NeverNotJohn/CSUF-NASA-USLI-2026/README.md

# California State University, Fresno NASA USLI 
California State University, Fresno (CSUF) GitHub for the 2025-2026 NASA USLI Competition 

## File Structure
### Hardware
Schematics, PCB, KiCad project, etc.
### Software
Code made in C/C++ using FreeRTOS and Arduino. Development using the PlatformIO IDE
