NeverNotJohn/CSUF-NASA-USLI-2026/payload/hardware/VDF/High_Voltage_Sled/CSUF-USLI-payload-2026.png

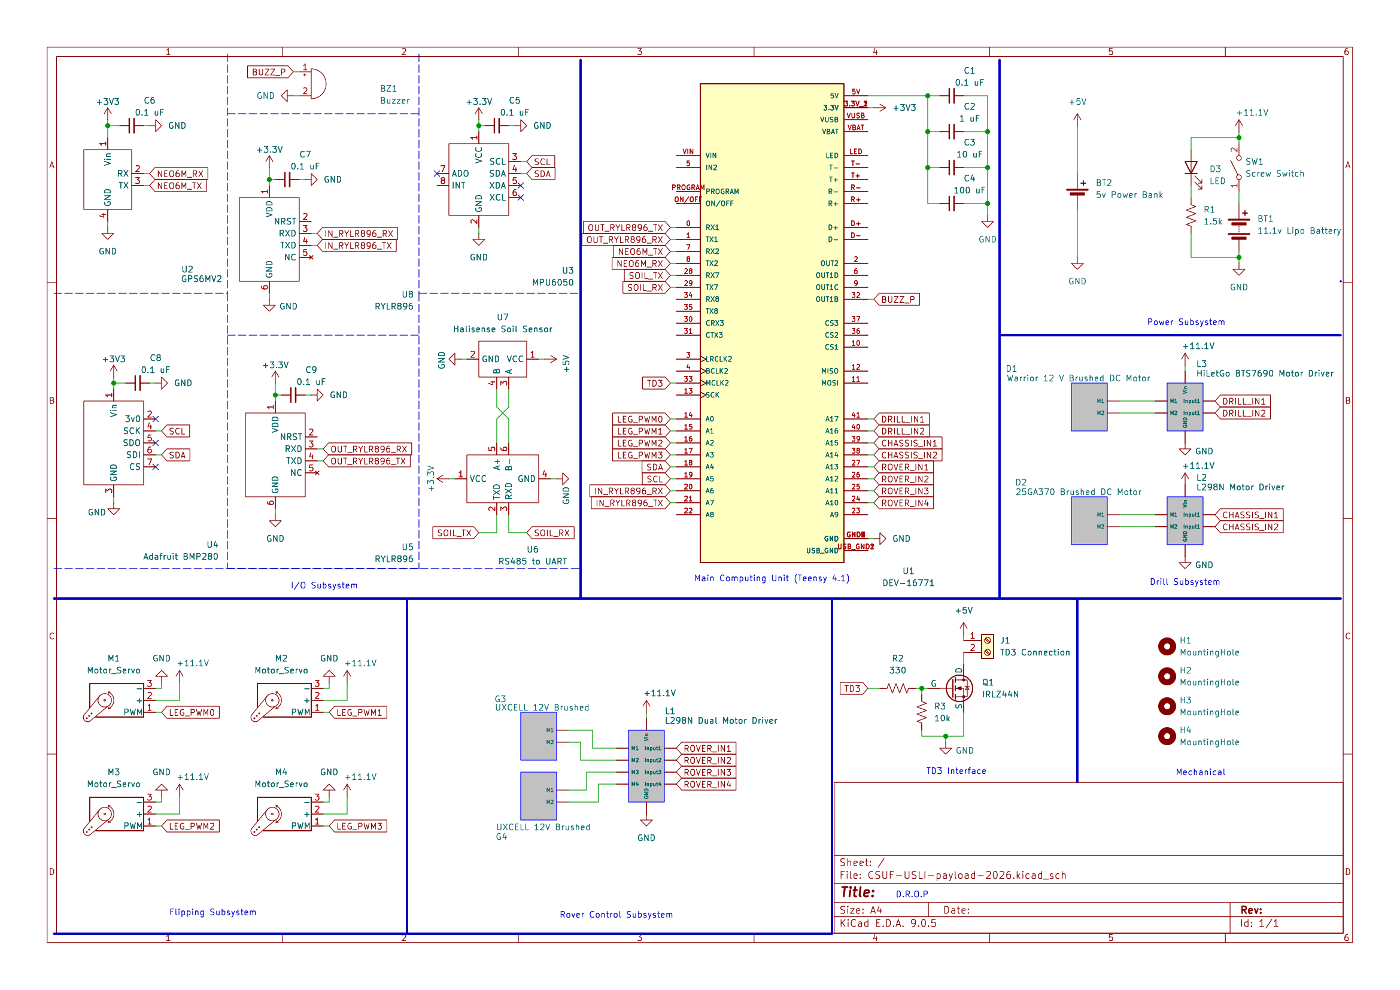
payload/hardware/VDF/High_Voltage_Sled/CSUF-USLI-payload-2026.png
