NeverNotJohn/CSUF-NASA-USLI-2026/payload/hardware/CSUF-USLI-payload-V2-2026/models/IRLZ44N.step

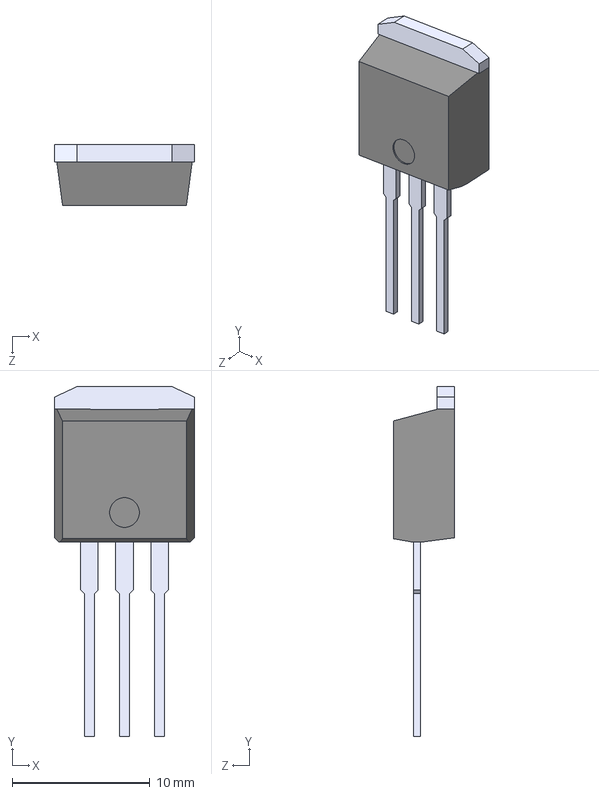
[picture p2: CAD file, 2026-03-28]
payload/hardware/CSUF-USLI-payload-V2-2026/models/IRLZ44N.step
10.2 x 25.4 x 4.44 mm
