NeverNotJohn/CSUF-NASA-USLI-2026/payload/hardware/CSUF-USLI-payload-V2-2026/models/DEV-16771.step

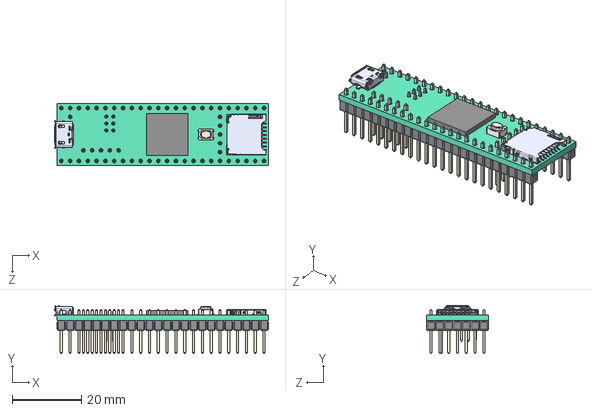
[picture p3: CAD file, 2025-10-14]
payload/hardware/CSUF-USLI-payload-V2-2026/models/DEV-16771.step
61.7 x 13.8 x 17.8 mm
