NeverNotJohn/CSUF-NASA-USLI-2026/payload/hardware/VDF/High_Voltage_Sled/CSUF-USLI-payload-2026.pdf

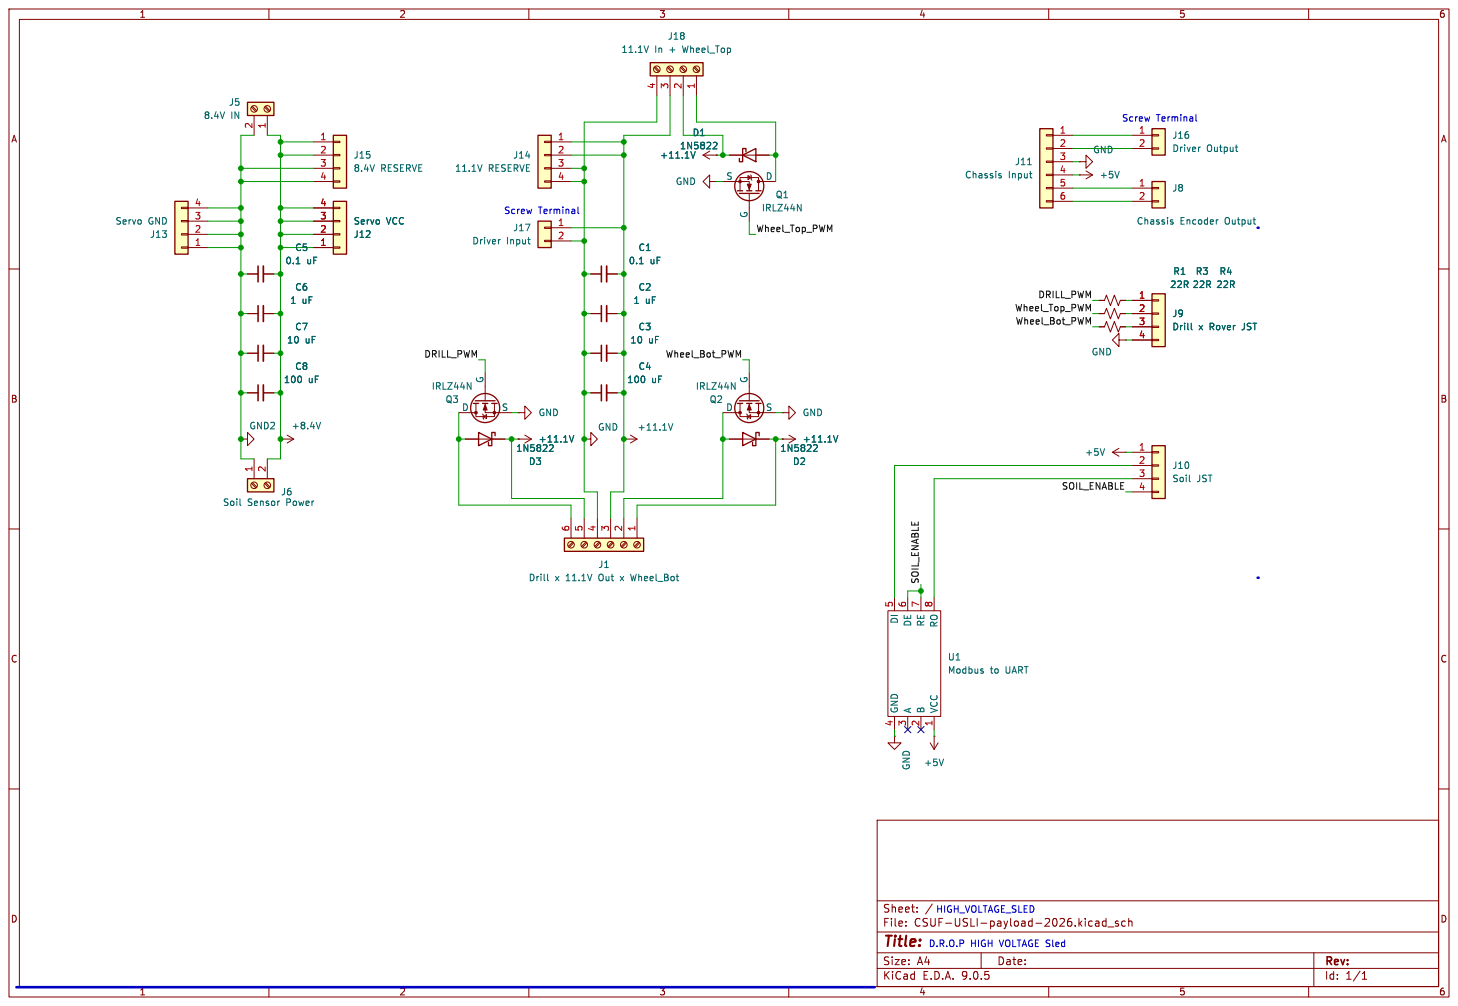
[picture p4: page 1]

J8 Chassis Encoder Output GND

Id: 1/1 Title: File: CSUF-USLI-payload-2026.kicad_sch Sheet: /
