NeverNotJohn/CSUF-NASA-USLI-2026/payload/hardware/VDF/Sensor_Sled/CSUF-USLI-payload-2026.pdf

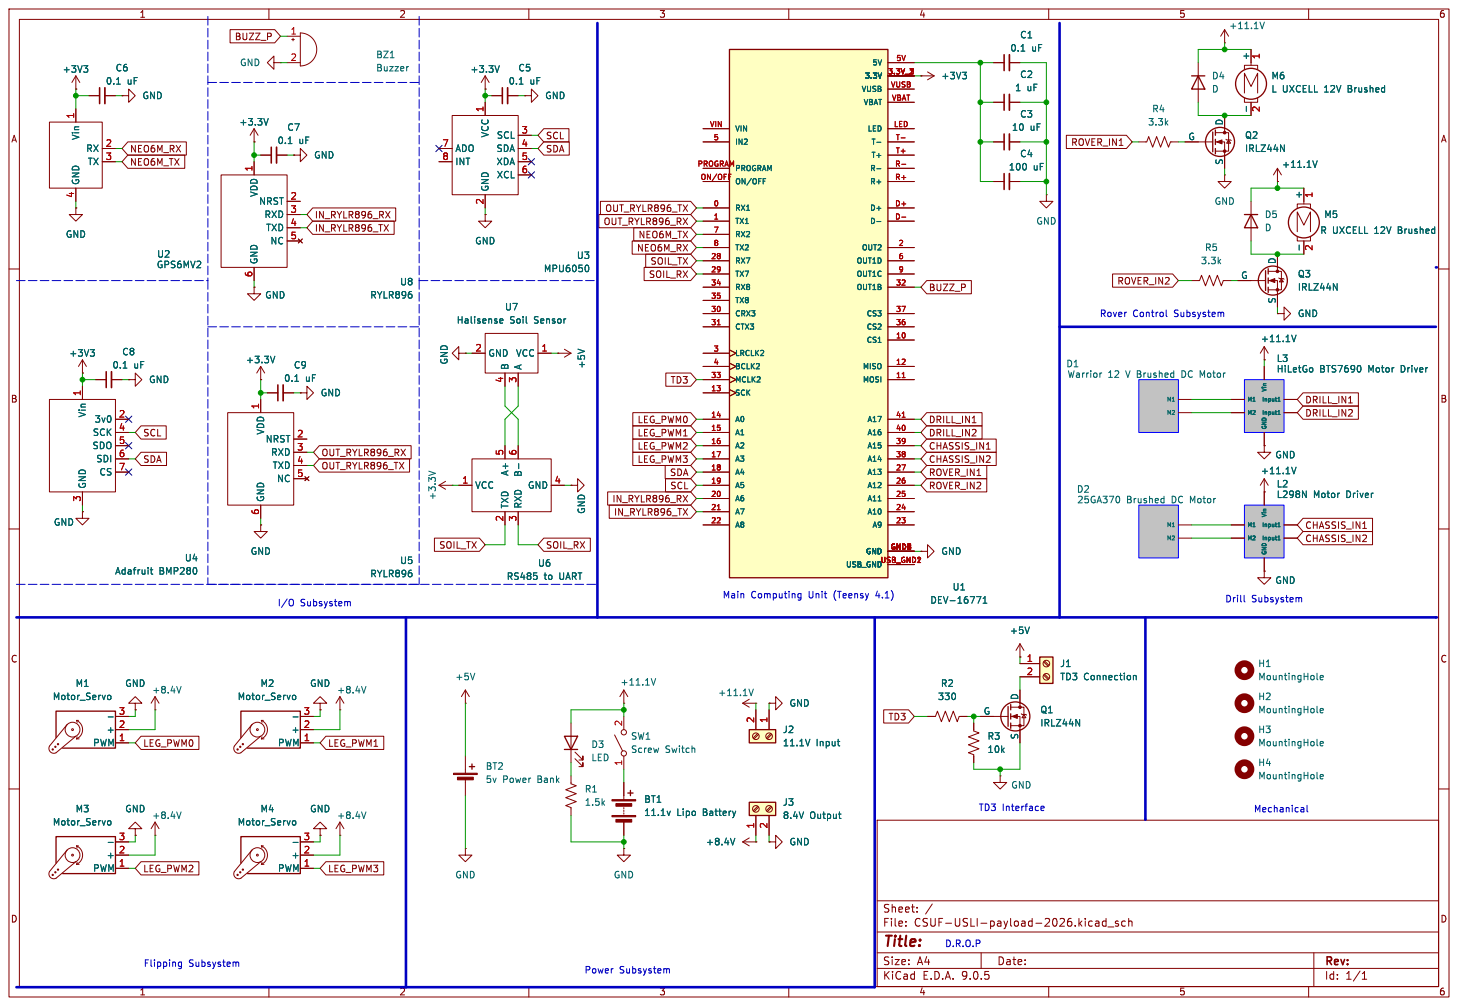
[picture p5: page 1]

2 SCL 3 SDA 4 XDA 5 XCL 6 +3.3V GND +5V U6 RS485 to UART TXD

6 NRST 2 RXD 3 TXD 4 NC 5 GND GND

2 SCL 3 SDA 4 XDA 5 XCL 6 U3 MPU6050 PWM 1 +

4 RX 2 TX 3 U2 GPS6MV2 GND GND

6 NRST 2 RXD 3 TXD 4 NC 5 U5 RYLR896 GNDVDD

6 NRST 2 RXD 3 TXD 4 NC 5 U8 RYLR896 +8.4V C9

4 U7 Halisense Soil Sensor GND

5 B- 6 U7 Halisense Soil Sensor VCC 1 GND 2 A

L3HiLetGo BTS7690 Motor Driver M1 M2 Vin GND

6 NRST 2 RXD 3 TXD 4 NC 5 GND

Input1L2
L298N Motor Driver M1 M2 Vin GND
M1 M2 Vin GND

H1 MountingHole H4 MountingHole H2 MountingHole H3 MountingHole G

Id: 1/1 Title: File: CSUF-USLI-payload-2026.kicad_sch Sheet: /
