NeverNotJohn/CSUF-NASA-USLI-2026/payload/hardware/CSUF-USLI-payload-V2-2026/main-board-v2.kicad_pcb

## KiCad design payload/hardware/CSUF-USLI-payload-V2-2026/main-board-v2.kicad_pcb (2026-04-13)

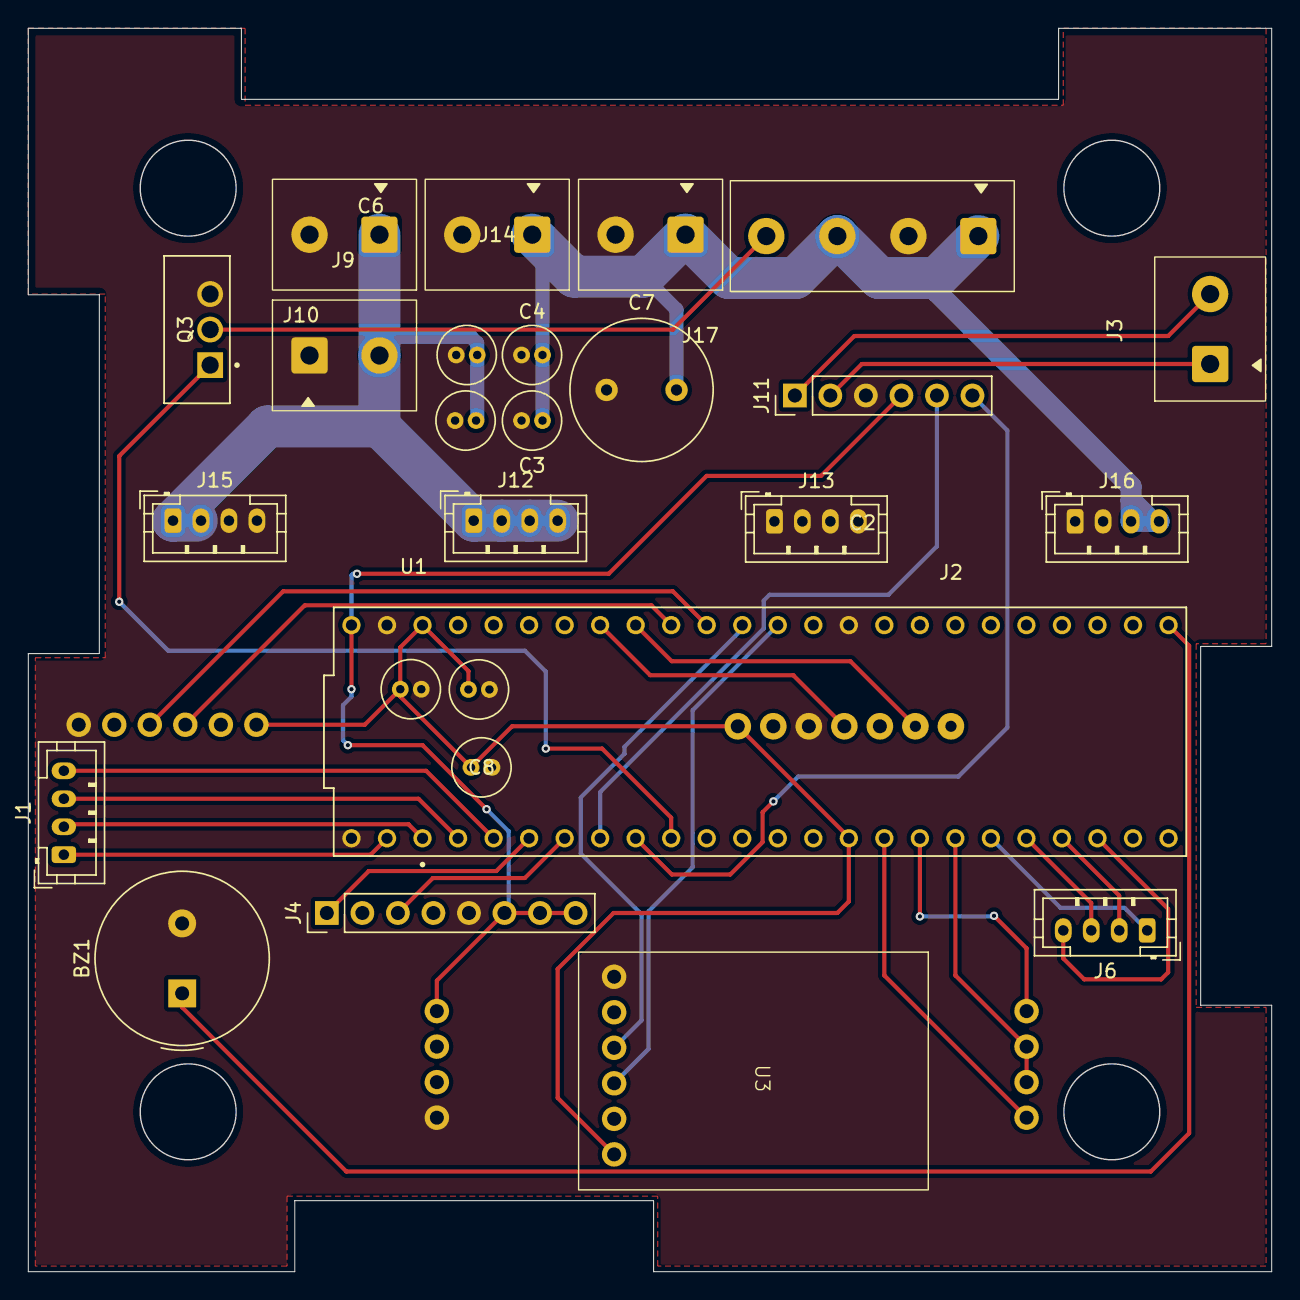
[picture p6: board main-board-v2.kicad_pcb from above]

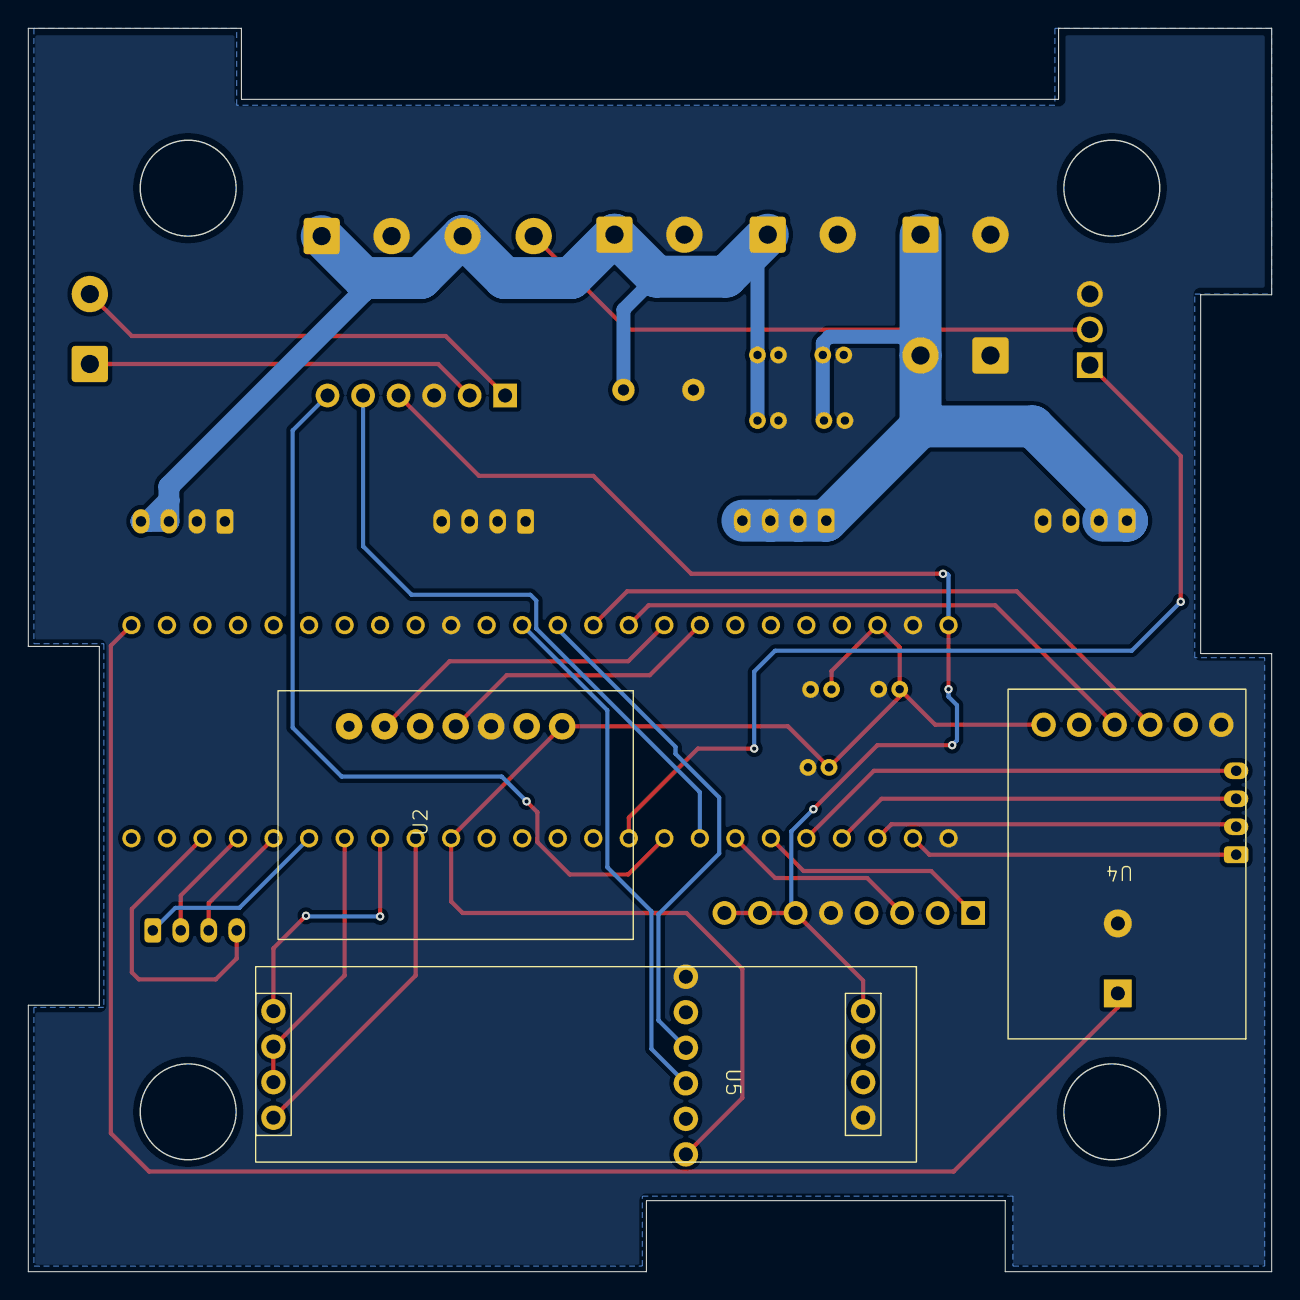
[picture p7: board main-board-v2.kicad_pcb from below]

Board: 2 copper layers, 88.9 x 88.9 mm, 29 parts (3 on the bottom side), 31 nets.

Parts:
BZ1: Buzzer; Buzzer_TDK_PS1240P02BT_D12.2mm_H6.5mm
C1, C2, C3, C5, C8: 0.1 uF; C_Radial_D4.0mm_H7.0mm_P1.50mm
C4, C6: 1 uF; C_Radial_D4.0mm_H7.0mm_P1.50mm
C7: 330 uF; C_Radial_D10.0mm_H12.5mm_P5.00mm
J1: Servo JST; JST_PH_B4B-PH-K_1x04_P2.00mm_Vertical
J2: Drill x 11.1V OUT; Edit_TerminalBlock_Phoenix_MKDS-1,5-2_1x04_P5.00mm_Horizont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
J3: Motor Power; Edit_TerminalBlock_Phoenix_MKDS-1,5-2_1x02_P5.00mm_Horizont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
J4: BTS7960 Output; PinHeader_1x08_P2.54mm_Vertical
J6: Reserve JST; JST_PH_B4B-PH-K_1x04_P2.00mm_Vertical
J9: Soil Sensor Power; Edit_TerminalBlock_Phoenix_MKDS-1,5-2_1x02_P5.00mm_Horizont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
J10: 8.4V IN; Edit_TerminalBlock_Phoenix_MKDS-1,5-2_1x02_P5.00mm_Horizont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
J11: Chassis Input; PinHeader_1x06_P2.54mm_Vertical
J12: Servo VCC; JST_PH_B4B-PH-K_1x04_P2.00mm_Vertical
J13: Servo GND; JST_PH_B4B-PH-K_1x04_P2.00mm_Vertical
J14: 11.1V IN; Edit_TerminalBlock_Phoenix_MKDS-1,5-2_1x02_P5.00mm_Horizont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
J15: 8.4V RESERVE; JST_PH_B4B-PH-K_1x04_P2.00mm_Vertical
J16: 11.1V RESERVE; JST_PH_B4B-PH-K_1x04_P2.00mm_Vertical
J17: Driver Input; Edit_TerminalBlock_Phoenix_MKDS-1,5-2_1x02_P5.00mm_Horizont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
Q3: IRLZ44N
U1: DEV-16771; MODULE_DEV-16771
U2: Adafruit BMP280; BMP280
U3, U4: RYLR896; REYAX RYLR896
U5: Modbus to UART; Modbus_to_UART

Connections:
+3V3: C1.1, C2.1, C8.1, U1.3.3V_1 (3.3V), U1.3.3V_2 (3.3V), U2.1 (Vin), U3.1 (VDD), U4.1 (VDD)
+5V: J4.6, J4.7, J4.8, J11.4, U1.VIN, U5.5 (VCC)
+8.4V: C5.2, C6.2, J9.2, J10.1, J12.1, J12.2, J12.3, J12.4, J15.1, J15.2
+11.1V: C3.2, C4.2, C7.2, J2.1, J2.3, J14.1, J16.3, J16.4, J17.1
Chassis_Encoder_A: J11.5, U1.6 (OUT1D)
Chassis_Encoder_B: J11.6, U1.7 (RX2)
DRILL: Q3.1 (G), U1.8 (TX2)
GND: BZ1.2 (-), C1.2, C2.2, C3.1, C4.1, C5.1, C6.1, C7.1, C8.2, J2.2, J4.5, J9.1, J10.2, J11.3, J13.1, J13.2, J13.3, J13.4, J14.2, J15.3, J15.4, J16.1, J16.2, J17.2, Q3.3 (S), U1.GND1 (GND), U1.GND2 (GND), U1.GND3 (GND), U2.3 (GND), U3.6 (GND), U4.6 (GND), U5.8 (GND)
LPWM: J4.3, U1.5 (IN2)
unnamed: BZ1.1 (+), U1.33 (MCLK2)
unnamed: J2.4, Q3.2 (D)
unnamed: J3.2, J11.1
unnamed: J3.1, J11.2
RESERVE_0: J6.1, U1.27 (A13)
RESERVE_1: J6.2, U1.29 (TX7)
RESERVE_2: J6.3, U1.28 (RX7)
RESERVE_3: J6.4, U1.30 (CRX3)
RPWM: J4.1, U1.4 (BCLK2)
RX3: U1.15 (A1), U3.4 (TXD)
RX4: U1.16 (A2), U4.4 (TXD)
RX6: U1.25 (A11), U5.4 (RO)
SCL: U1.19 (A5), U2.4 (SCK)
SDA: U1.18 (A4), U2.6 (SDI)
SERVO_0: J1.1, U1.0 (RX1)
SERVO_1: J1.2, U1.1 (TX1)
SERVO_2: J1.3, U1.2 (OUT2)
SERVO_3: J1.4, U1.3 (LRCLK2)
SOIL_ENABLE: U1.26 (A12), U5.2 (DE), U5.3 (RE)
TX3: U1.14 (A0), U3.3 (RXD)
TX4: U1.17 (A3), U4.3 (RXD)
TX6: U1.24 (A10), U5.1 (DI)
