NeverNotJohn/CSUF-NASA-USLI-2026/payload/hardware/VDF/Transmission_Sled/CSUF-USLI-payload-2026.kicad_pcb

## KiCad design payload/hardware/VDF/Transmission_Sled/CSUF-USLI-payload-2026.kicad_pcb (2026-03-28)

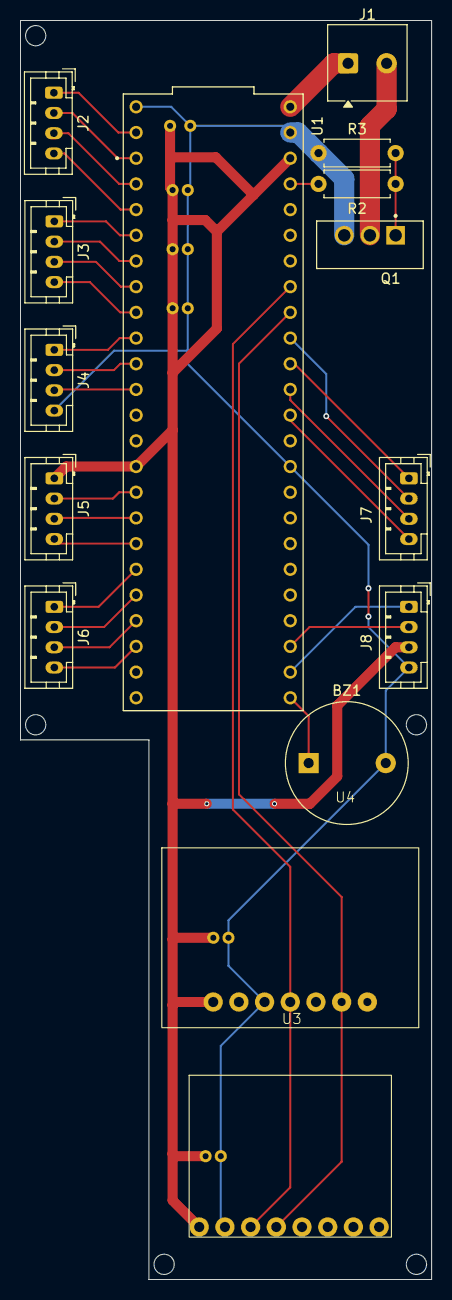
[picture p8: board CSUF-USLI-payload-2026.kicad_pcb from above]

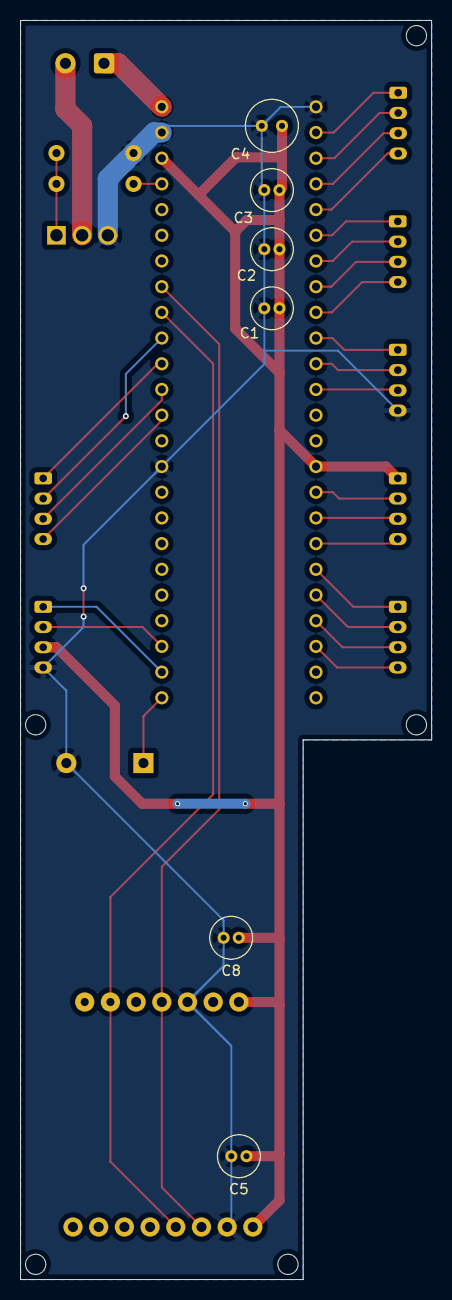
[picture p9: board CSUF-USLI-payload-2026.kicad_pcb from below]

Board: 2 copper layers, 40.6 x 124.5 mm, 21 parts (6 on the bottom side), 33 nets.

Parts:
BZ1: Buzzer; Buzzer_TDK_PS1240P02BT_D12.2mm_H6.5mm
C1, C5, C8: 0.1 uF; C_Radial_D4.0mm_H7.0mm_P1.50mm
C2: 1 uF; C_Radial_D4.0mm_H7.0mm_P1.50mm
C3: 10 uF; C_Radial_D4.0mm_H7.0mm_P1.50mm
C4: 100 uF; C_Radial_D5.0mm_H7.0mm_P2.00mm
J1: TD3 Connection; TerminalBlock_Phoenix_MKDS-1-2-3.81_1x02_P3.81mm_Horizontal
J2: Servo JST; JST_PH_B4B-PH-K_1x04_P2.00mm_Vertical
J3: Chassis JST; JST_PH_B4B-PH-K_1x04_P2.00mm_Vertical
J4: Drill x Rover JST; JST_PH_B4B-PH-K_1x04_P2.00mm_Vertical
J5: Soil JST; JST_PH_B4B-PH-K_1x04_P2.00mm_Vertical
J6: Reserve JST; JST_PH_B4B-PH-K_1x04_P2.00mm_Vertical
J7: RYLR896 JST; JST_PH_B4B-PH-K_1x04_P2.00mm_Vertical
J8: GPS x Power JST; JST_PH_B4B-PH-K_1x04_P2.00mm_Vertical
Q1: IRLZ44N
R2: 330; R_Axial_DIN0207_L6.3mm_D2.5mm_P7.62mm_Horizontal
R3: 10k; R_Axial_DIN0207_L6.3mm_D2.5mm_P7.62mm_Horizontal
U1: DEV-16771; MODULE_DEV-16771
U3: MPU6050
U4: Adafruit BMP280; BMP280

Connections:
+3V3: C1.1, C2.1, C3.1, C4.1, C5.1, C8.1, J5.1, J8.3, U1.3.3V_1 (3.3V), U1.3.3V_2 (3.3V), U3.1 (VCC), U4.1 (Vin)
+5V: J1.1, U1.VIN
/Chassis_Encoder_A: J3.3, U1.6 (OUT1D)
/Chassis_Encoder_B: J3.4, U1.7 (RX2)
/Chassis_Out_0: J3.1, U1.4 (BCLK2)
/Chassis_Out_1: J3.2, U1.5 (IN2)
/DRILL: J4.1, U1.8 (TX2)
/RESERVE_0: J6.1, U1.27 (A13)
/RESERVE_1: J6.2, U1.28 (RX7)
/RESERVE_2: J6.3, U1.29 (TX7)
/RESERVE_3: J6.4, U1.30 (CRX3)
/ROVER_BOT: J4.3, U1.10 (CS1)
/ROVER_TOP: J4.2, U1.9 (OUT1C)
/RX3: J7.3, U1.15 (A1)
/RX4: J7.1, U1.16 (A2)
/RX6: J5.3, U1.25 (A11)
/RX8: J8.1, U1.34 (RX8)
/SERVO_0: J2.1, U1.0 (RX1)
/SERVO_1: J2.2, U1.1 (TX1)
/SERVO_2: J2.3, U1.2 (OUT2)
/SERVO_3: J2.4, U1.3 (LRCLK2)
/SOIL_ENABLE: J5.4, U1.26 (A12)
/TX3: J7.4, U1.14 (A0)
/TX4: J7.2, U1.17 (A3)
/TX6: J5.2, U1.24 (A10)
/TX8: J8.2, U1.35 (TX8)
GND: BZ1.2 (-), C1.2, C2.2, C3.2, C4.2, C5.2, C8.2, J4.4, J8.4, Q1.3 (S), R3.1, U1.GND1 (GND), U1.GND2 (GND), U1.GND3 (GND), U3.2 (GND), U4.3 (GND)
unnamed: BZ1.1 (+), U1.33 (MCLK2)
unnamed: J1.2, Q1.2 (D)
unnamed: Q1.1 (G), R2.2, R3.2
unnamed: U1.18 (A4), U3.4 (SDA), U4.6 (SDI)
unnamed: U1.19 (A5), U3.3 (SCL), U4.4 (SCK)
unnamed: R2.1, U1.23 (A9)
