NeverNotJohn/CSUF-NASA-USLI-2026/payload/hardware/VDF/High_Voltage_Sled/High_Voltage_Sled.kicad_pcb

## KiCad design payload/hardware/VDF/High_Voltage_Sled/High_Voltage_Sled.kicad_pcb (2026-03-28)

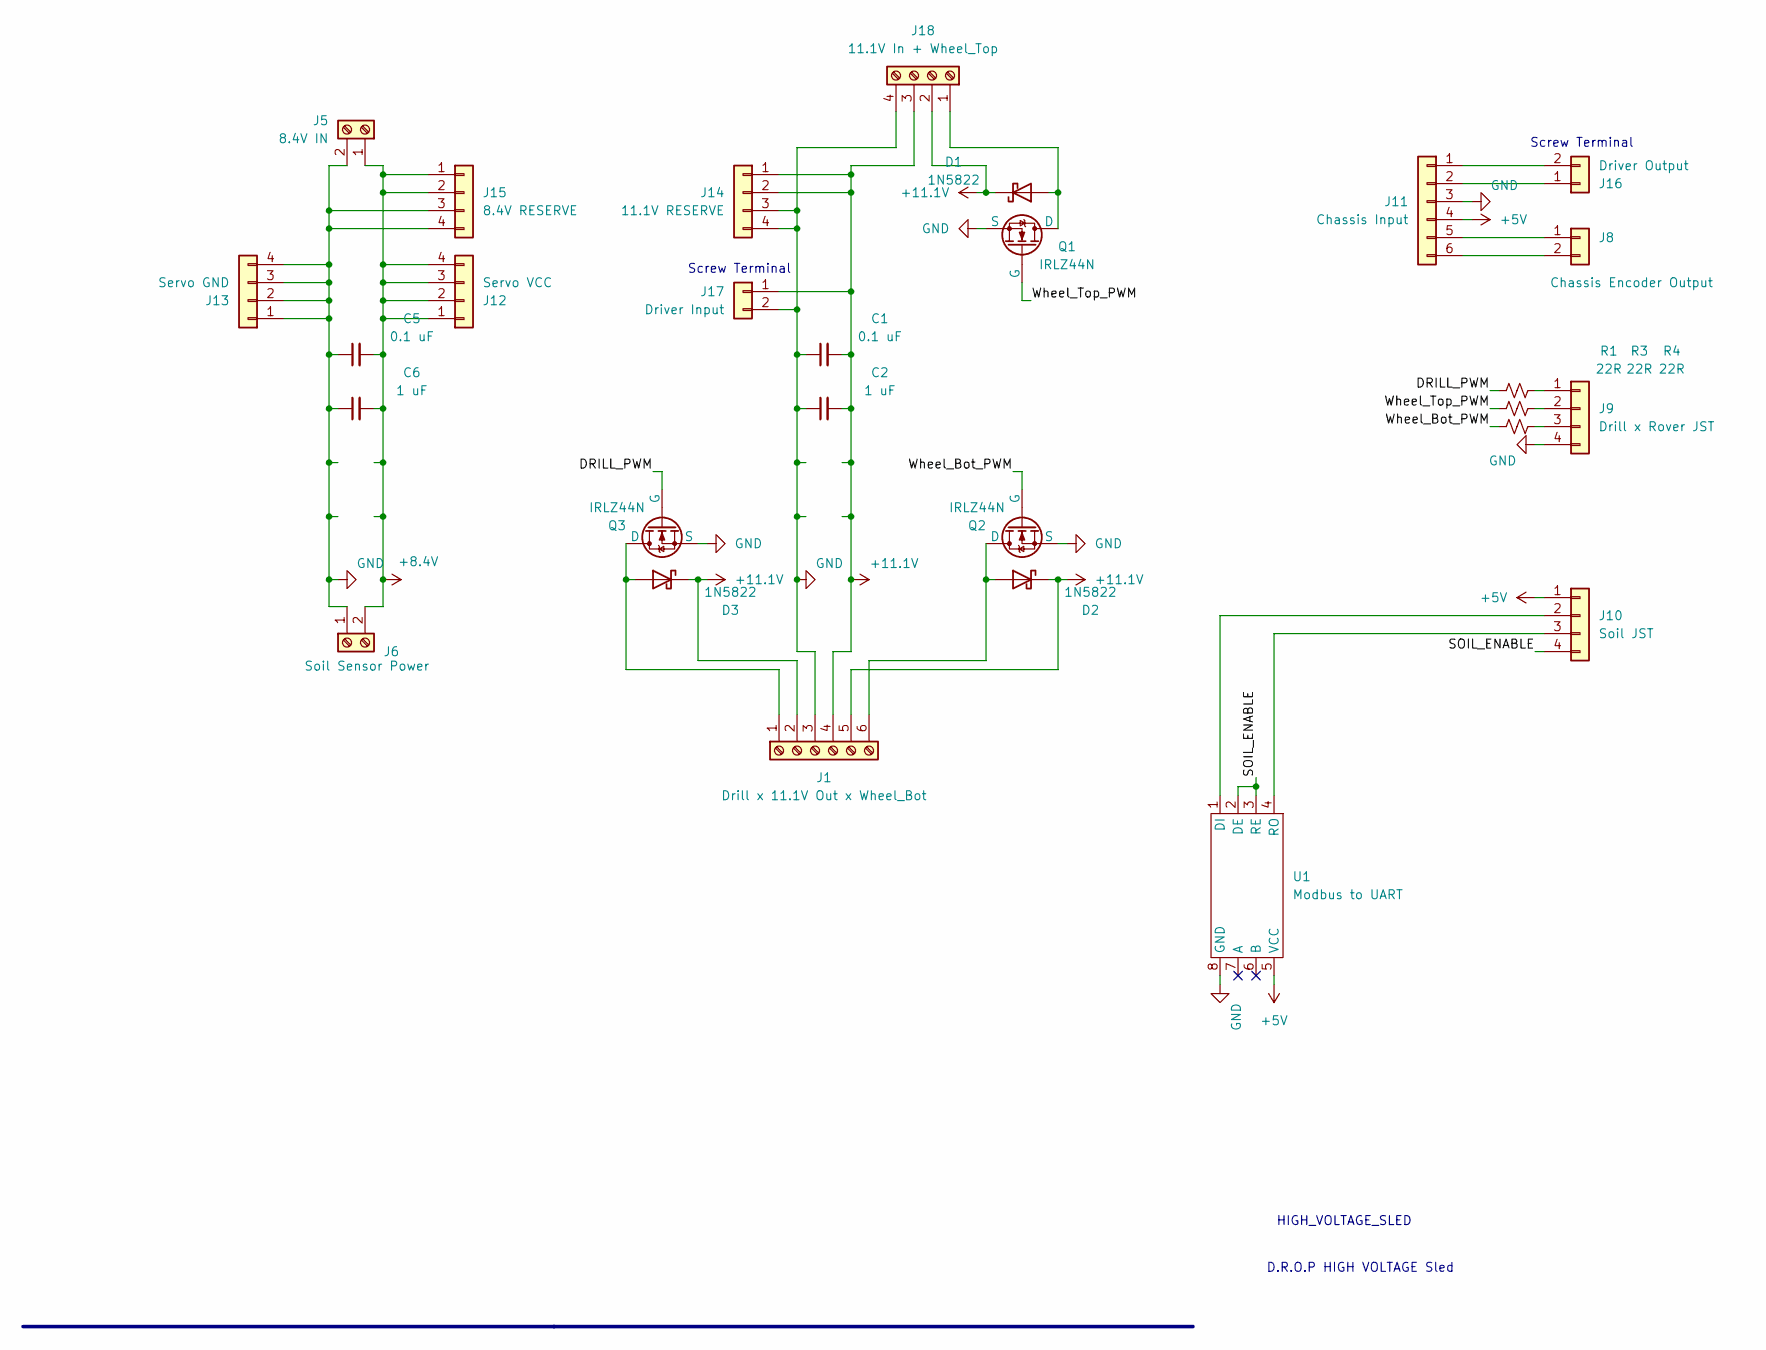
[picture p10: schematic High_Voltage_Sled.kicad_sch]

Parts:
C1, C5: 0.1 uF; C_Radial_D4.0mm_H7.0mm_P1.50mm
C2, C6: 1 uF; C_Radial_D4.0mm_H7.0mm_P1.50mm
D1, D2, D3: 1N5822; D_DO-201AD_P15.24mm_Horizontal
J1: Drill x 11.1V Out x Wheel_Bot; Edit_TerminalBlock_Phoenix_MKDS-1,5-2_1x06_P5.00mm_Horizont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
J5: 8.4V IN; Edit_TerminalBlock_Phoenix_MKDS-1,5-2_1x02_P5.00mm_Horizont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
J6: Soil Sensor Power; Edit_TerminalBlock_Phoenix_MKDS-1,5-2_1x02_P5.00mm_Horizont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
J8: Chassis Encoder Output; JST_PH_B2B-PH-K_1x02_P2.00mm_Vertical
J9: Drill x Rover JST; JST_PH_B4B-PH-K_1x04_P2.00mm_Vertical
J10: Soil JST; JST_PH_B4B-PH-K_1x04_P2.00mm_Vertical
J11: Chassis Input; PinHeader_1x06_P2.54mm_Vertical
J12: Servo VCC; JST_PH_B4B-PH-K_1x04_P2.00mm_Vertical
J13: Servo GND; JST_PH_B4B-PH-K_1x04_P2.00mm_Vertical
J14: 11.1V RESERVE; JST_PH_B4B-PH-K_1x04_P2.00mm_Vertical
J15: 8.4V RESERVE; JST_PH_B4B-PH-K_1x04_P2.00mm_Vertical
J16: Driver Output; Edit_TerminalBlock_Phoenix_MKDS-1,5-2_1x02_P5.00mm_Horizont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
J17: Driver Input; Edit_TerminalBlock_Phoenix_MKDS-1,5-2_1x02_P5.00mm_Horizont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
J18: 11.1V In + Wheel_Top; Edit_TerminalBlock_Phoenix_MKDS-1,5-2_1x04_P5.00mm_Horizont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
Q1, Q2, Q3: IRLZ44N
R1, R3, R4: 22R; R_Axial_DIN0207_L6.3mm_D2.5mm_P2.54mm_Vertical
U1: Modbus to UART; Modbus_to_UART

Connections:
+5V: J10.1, J11.4, U1.5 (VCC)
+8.4V: C5.2, C6.2, J5.1, J6.2, J12.1, J12.2, J12.3, J12.4, J15.1, J15.2
+11.1V: C1.2, C2.2, D1.1 (K), D2.1 (K), D3.1 (K), J1.2, J1.4, J1.5, J14.1, J14.2, J17.1, J18.2, J18.3
/DRILL_PWM: Q3.1 (G), R4.1
/SOIL_ENABLE: J10.4, U1.2 (DE), U1.3 (RE)
/Wheel_Bot_PWM: Q2.1 (G), R3.1
/Wheel_Top_PWM: Q1.1 (G), R1.1
GND: C1.1, C2.1, C5.1, C6.1, J1.3, J5.2, J6.1, J9.4, J11.3, J13.1, J13.2, J13.3, J13.4, J14.3, J14.4, J15.3, J15.4, J17.2, J18.4, Q1.3 (S), Q2.3 (S), Q3.3 (S), U1.8 (GND)
unnamed: D1.2 (A), J18.1, Q1.2 (D)
unnamed: D2.2 (A), J1.6, Q2.2 (D)
unnamed: D3.2 (A), J1.1, Q3.2 (D)
unnamed: J9.1, R4.2
unnamed: J9.2, R1.2
unnamed: J9.3, R3.2
unnamed: J10.2, U1.1 (DI)
unnamed: J10.3, U1.4 (RO)
unnamed: J11.1, J16.2
unnamed: J11.2, J16.1
unnamed: J8.1, J11.5
unnamed: J8.2, J11.6

Notes on the sheet:
Screw Terminal
HIGH_VOLTAGE_SLED
D.R.O.P HIGH VOLTAGE Sled

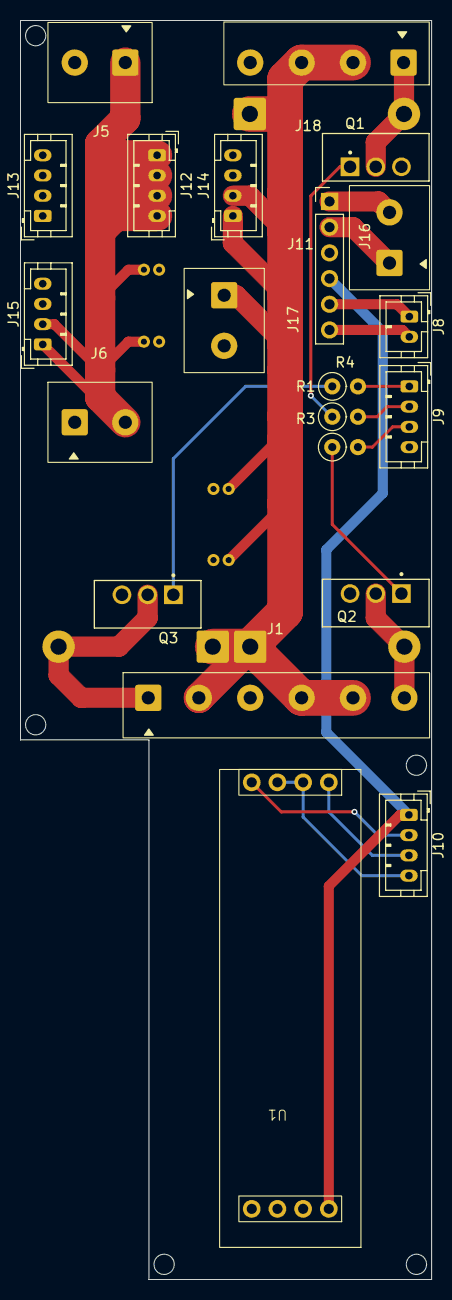
[picture p11: board High_Voltage_Sled.kicad_pcb from above]

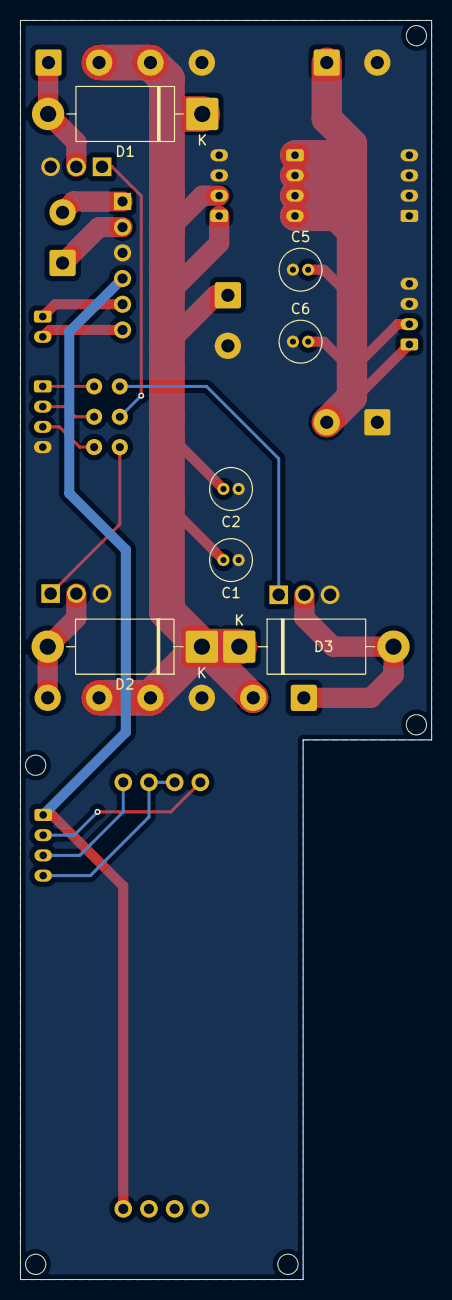
[picture p12: board High_Voltage_Sled.kicad_pcb from below]

Board: 2 copper layers, 40.6 x 124.5 mm, 28 parts (7 on the bottom side), 20 nets.
