NeverNotJohn/CSUF-NASA-USLI-2026/payload/software/main/include/defines.h

/******************** DEFINITIONS GO HERE ********************/
#ifndef DEFINES_H
#define DEFINES_H

#include <Arduino.h>
#include <iostream>
#include <stdint.h>

/************** FLAGS **************/
#define ANNOY_CYAN          1
 
// Preflight
#define TRIGGER_FT          5       // OFFICIAL: 30

// Inflight
#define FLIGHT_TIMEOUT_S    900      // OFFICIAL 900
#define GROUND_COUNTER_MAX  250

// Postflight
#define POST_FLIGHT_TIME_S  900      // OFFICIAL: 900 = 15 minutes

/************** PINS **************/
#define LED_OUTPUT_PIN      13      // 28 is fried lol
#define TD3_PIN             23
#define BUZZ_PIN            33 
#define LED_INTERNAL_PIN    13
#define DRILL_PIN           8
#define CHASSIS_PIN_0       4
#define CHASSIS_PIN_1       5

/************** SETTINGS **************/
#define USB_BAUD_RATE       9600
#define DATA_LOG_SIZE       10416
#define SOIL_LOG_SIZE       2604
#define LOGGER_PERIOD_MS    500
// typedefs & structs

typedef struct {
    uint32_t n;
    uint8_t hour;
    uint8_t min;
    uint8_t sec;
    float altitude_ft;
    float lng;
    float lat;
    float roll_deg;
    float pitch_deg;
    float yaw_deg;
    uint8_t missionState;
} DataPacket;

typedef struct {
    uint16_t n;
    uint8_t hour;
    uint8_t min;
    uint8_t sec;
    float pH;
    float EC;
} SoilPacket;

typedef struct {
    DataPacket data[DATA_LOG_SIZE];
    int size;
} DataPacketLog;

typedef struct {
    SoilPacket data[SOIL_LOG_SIZE];
    int size;
} SoilPacketLog;

// typedef struct {
//     double x;
//     double y;
//     double z;
// } Vector3D;

typedef enum {
    PRE_FLIGHT,
    IN_FLIGHT,
    POST_FLIGHT,
    MISSION_END
} MissionState;

#endif // DEFINES_H
