NeverNotJohn/CSUF-NASA-USLI-2026/payload/software/main/include/motor.h

/*****************************************
 * 
 * Polulu 2358 Motor Driver Header File
 * 
 *****************************************/

#ifndef MOTOR_H
#define MOTOR_H

// Stuff
void myFunction(int a, int b);

#endif // MOTOR_H
