NeverNotJohn/CSUF-NASA-USLI-2026/payload/software/main/src/motor.cpp

/*****************************************
 * 
 * Polulu 2358 Motor Driver Source File
 * 
 *****************************************/

#include "motor.h"
#include "defines.h"

using namespace std;

/**
 *  This Function prints Hello World!
 *  Use this as a template
 *  
 *  Input:
 *      a -> The first operand
 *      b -> The second operand
 *  Output:
 *      Hello world
 */
void myFunction(int a, int b) 
{
    cout << "Hello World!" << endl;
}
