NeverNotJohn/CSUF-NASA-USLI-2026/payload/software/main/src/flip.cpp

/*****************************************
 * 
 * Flip Source File
 * 
 *****************************************/

#include <Arduino.h>
#include "servocontrol.h"
#include "flip.h"
/************** STATIC VARS **************/
ServoControl servos[NUM_SERVOS] = {};
#define SERVO_SPEED_MS 500
/************** FUNCTIONS **************/

void initLegs(int servoPins[NUM_SERVOS])
{
    Serial.println("initializing legs...");
    for (int i = 0; i < NUM_SERVOS; i++) {
      ServoControl servo = ServoControl();
      servos[i] = servo;
      servos[i].init(servoPins[i], 175); // attach servo to pin with 175 deg start angle
    }
    Serial.println("legs initialized!");    
    
}


void standUp()
{
    for (int i = 0; i < NUM_SERVOS; i++) {
                servos[i].prepareAngle(25, SERVO_SPEED_MS);
            }
            synchronizeAllServosStartAndWaitForAllServosToStop();
        //     delay(500);
        //     for (int i = 0; i < NUM_SERVOS; i++) {
        //         servos[i].prepareAngle(175, 1000);
        //     }
        // synchronizeAllServosStartAndWaitForAllServosToStop();
}

void standDown()
{
    for (int i = 0; i < NUM_SERVOS; i++) {
            servos[i].prepareAngle(175, SERVO_SPEED_MS);
    }
    synchronizeAllServosStartAndWaitForAllServosToStop();
    // for (int i = 0; i < NUM_SERVOS/2; i++) {
    //     servos[i].prepareAngle(0, SERVO_SPEED_MS);
    //     servos[i+2].prepareAngle(90, SERVO_SPEED_MS);

    // }
    // synchronizeAllServosStartAndWaitForAllServosToStop();
    // delay(500);
    // for (int i = 0; i < NUM_SERVOS; i++) {
    //     servos[i].prepareAngle(175, SERVO_SPEED_MS);
    // }
    // synchronizeAllServosStartAndWaitForAllServosToStop();

}

void sixtySeven(){
    for (int i = 0; i < 2; i++) {
        servos[i].prepareAngle(90, SERVO_SPEED_MS);
        servos[i+1].prepareAngle(150, SERVO_SPEED_MS);
    }
    synchronizeAllServosStartAndWaitForAllServosToStop();
    delay(500);
    for (int i = 0; i < 2; i++) {
        servos[i+1].prepareAngle(90, SERVO_SPEED_MS);
        servos[i].prepareAngle(150, SERVO_SPEED_MS);
    }
    synchronizeAllServosStartAndWaitForAllServosToStop();
}
