NeverNotJohn/CSUF-NASA-USLI-2026/payload/software/main/src/RYLR896.cpp

/*****************************************
 * 
 * RYLR896 LoRa Telemetry Source File
 * 
 *****************************************/

#include "RYLR896.h"
#include "bmp280.h"
#include "defines.h"
#include <stdint.h>
#include "arduino_freertos.h"
#include "serialUSLI.h"
#include "beep.h"
#include "flip.h"
void sixtySeven();

/******** DEFINES ********/

typedef enum
{
    CMD_OK,
    CMD_CALIBRATE,
    CMD_SIX_SEVEN,
    CMD_LEGS_TEST,
    CMD_DRILL_TEST,
    CMD_ARM
} RxCommands;
int servoPins[4] = {0,1,2,3};

/******** EXTERN VARS ********/
TaskHandle_t rxHandle = NULL;

/******** STATIC VARS ********/
SemaphoreHandle_t rylr896Mutex;
SemaphoreHandle_t flagMutex;
int armedFlag = 0;
int legsTestFlag = 0;
int drillTestFlag = 0;

/******** STATIC FUNCTIONS ********/
// 1 = success, 0 = failure
// FIXME
static bool sendCommand(String cmd)
{
    String cmdTemp = cmd + "\r\n";
    String reply = "";

    if (xSemaphoreTake(rylr896Mutex, portMAX_DELAY) == pdTRUE)
    {
        RYLR896_SERIAL.print(cmdTemp);
        xSemaphoreGive(rylr896Mutex);
    }

    vTaskDelay(500);                                                // Wait for +OK

    return 1;
}

static bool sendCommandInput(String cmd)
{
    String cmdTemp = cmd + "\r\n";
    String reply = "";

    RYLR896_SERIAL_IN.print(cmdTemp);

    vTaskDelay(500);                                                // Wait for +OK

    return 1;
}

uint32_t decodePacket(String line)
{
    uint32_t result = CMD_OK; 
    if (line == "+OK") return CMD_OK;
    
    // Decode Data Packet
    char data;
    char c;
    int counter = 0;
    for (int i = 0; i < line.length(); i++)
    {
        c = line[i];
        if (counter == 2)   
        {  
            data = c;
            break;
        }
        else if (c == ',') ++counter;
    }

    switch (data)
    {
        case 'C':
            result = CMD_CALIBRATE;
            break;
        case 'A':
            result = CMD_ARM;
            break;
        case 'L':
            result = CMD_LEGS_TEST;
            break;
        case 'D':
            result = CMD_DRILL_TEST;
            break;
        case '6':
            result = CMD_SIX_SEVEN;
            break;
        
        
    }
    return result;
}

/******** EXTERNAL FUNCTIONS ********/

bool checkArmFlag()
{
    int result = 0;
    if (xSemaphoreTake(flagMutex, portMAX_DELAY) == pdTRUE)
    {
        result = armedFlag;
        xSemaphoreGive(flagMutex);
    }
    return result;
}

void rxTask(void *pvParameters)
{
    String line;
    int cmd;
    for (;;)
    {
        if (RYLR896_SERIAL_IN.available())
        {
            line = RYLR896_SERIAL_IN.readStringUntil('\n');
            line.trim();

            // Debug
            Serial.println(line);
            
            cmd = decodePacket(line);

            switch (cmd)
            {
                case CMD_CALIBRATE:
                    Serial.println("Calibrating!");
                    calibrateBMP();
                    beep(3, 100, 50);
                    break;
                case CMD_ARM:
                    Serial.println("Arming! Watch yo fingers.");
                    initLegs(servoPins);
                    if (xSemaphoreTake(flagMutex, portMAX_DELAY) == pdTRUE)
                    {
                        armedFlag = 1;
                        xSemaphoreGive(flagMutex);
                    }
                    beep(1, 3000, 0);
                    
                    break;
               // toggle on CMD_DRILL_TEST:
                case CMD_DRILL_TEST:
                    if (xSemaphoreTake(flagMutex, portMAX_DELAY) == pdTRUE)
                    {
                        drillTestFlag ^= 1;   // xor toggle
                        xSemaphoreGive(flagMutex);
                    }
                    digitalWrite(DRILL_PIN, drillTestFlag);
                    break;

                case CMD_LEGS_TEST:
                    if (!checkArmFlag()) break;
                    if (xSemaphoreTake(flagMutex, portMAX_DELAY) == pdTRUE)
                    {
                        legsTestFlag ^= 1; 
                        xSemaphoreGive(flagMutex);
                    }

                    if (legsTestFlag)
                        standUp(); 
                    else
                        standDown(); 
                    break;
                case CMD_SIX_SEVEN:
                    if(!checkArmFlag()) {
                        Serial.println("Payload is not armed!");
                        break;
                    }
                    
                    Serial.println("67676767");
                    for (int i = 0; i < 10; i++)
                    {
                        sixtySeven();
                        // vTaskDelay(pdMS_TO_TICKS(500));
                    }
                    

                    break;
            }

        }
        
        vTaskDelay(pdMS_TO_TICKS(100));
    }
}

void initRYLR896()
{
    RYLR896_SERIAL.begin(RYLR896_BAUD_RATE);
    RYLR896_SERIAL_IN.begin(RYLR896_BAUD_RATE);
    rylr896Mutex = xSemaphoreCreateMutex();
    flagMutex = xSemaphoreCreateMutex();

    sendCommand("AT+ADDRESS=12");
    sendCommand("AT+NETWORKID=4");
    sendCommand("AT+BAND=901000000");
    sendCommand("AT+PARAMETER=10,7,1,7");

    sendCommandInput("AT+ADDRESS=13");
    sendCommandInput("AT+NETWORKID=4");
    sendCommandInput("AT+BAND=915000000");
    sendCommandInput("AT+PARAMETER=10,7,1,7");

    vTaskDelay(1000);                                               // RYLR896 Needs time to setup

    // Clear Input Buffer
    if (xSemaphoreTake(rylr896Mutex, portMAX_DELAY) == pdTRUE)
    {
        while (RYLR896_SERIAL.available())            
            RYLR896_SERIAL.read(); 
    
        xSemaphoreGive(rylr896Mutex);
    }

    xTaskCreate(rxTask, "RX Task", 4096, NULL, 1, &rxHandle);
}       

// Send data via RYLR896, 1 if success, 0 if fail
bool txRYLR896(const char* data)
{
    char buf[256];
    snprintf(buf, sizeof(buf), "AT+SEND=1,%i,%s", strlen(data), data);

    // Debug
    if (openUSB())
    {
        Serial.print("Sending Message: ");
        Serial.println(buf);
        closeUSB();
    }

    return sendCommand(buf);
}
