NeverNotJohn/CSUF-NASA-USLI-2026/payload/software/main/include/flip.h

/*****************************************
 * 
 * Flipping Header File
 * 
 * for flippl
 *****************************************/

#ifndef FLIP_H
#define FLIP_H
#include "Servo.h"
#include "servocontrol.h"
/************** DEFINES **************/
#define NUM_SERVOS 4
/************** DEFINITION **************/
void initLegs(int servoPins[NUM_SERVOS]);
void standUp();
void standDown();
void sixtySeven();

#endif // FLIP_H
