NeverNotJohn/CSUF-NASA-USLI-2026/payload/software/main/include/beep.h

/*****************************************
 * 
 * Beep Header File
 * 
 * Buzzer
 *****************************************/

#ifndef BEEP_H
#define BEEP_H

/************** EXTERNAL FUNCTIONS **************/
void initBeep();
void beep(int numBeeps, double onInterval_ms, double offInterval_ms);

#endif // BEEP_H
