NeverNotJohn/CSUF-NASA-USLI-2026/payload/software/main/include/serialUSLI.h

/*****************************************
 * 
 * Serial Port Header File 
 * 
 ****************************************/

#ifndef SERIALUSLI_H
#define SERIALUSLI_H


/******** FUNCTIONS ********/
void initUSB();
bool openUSB();
bool closeUSB();

#endif // SERIALUSLI_H
