NeverNotJohn/CSUF-NASA-USLI-2026/(commit log)

2025-09-26 Added KiCad
    [main_v1.kicad_pcb, main_v1.kicad_sch]
2025-10-01 Made updates to the file structure
    [main_v1.kicad_pcb, main_v1.kicad_sch]
2025-10-14 changed git ignore to ignore KiCad stuff
2025-10-14 changed naming convention
    [main_v1.kicad_pcb, main_v1.kicad_sch]
2025-10-14 Merging Init PCB changes
    [CSUF-USLI-payload-2026.kicad_pcb, CSUF-USLI-payload-2026.kicad_sch, DEV-16771.step]
2025-10-15 made some changes
    [CSUF-USLI-payload-2026.kicad_sch]
2025-10-15 asdAdded changes n stuff
    [CSUF-USLI-payload-2026.kicad_sch]
2025-10-17 Motor Diagram Concept
    [CSUF-USLI-payload-2026.kicad_sch]
2025-10-18 Added decoupling capacitors
    [CSUF-USLI-payload-2026.kicad_sch]
2025-10-20 added BMP280
    [CSUF-USLI-payload-2026.kicad_sch]
2025-10-20 Added the final soil sensors
    [CSUF-USLI-payload-2026.kicad_sch]
2025-10-27 idk what change i did
    [CSUF-USLI-payload-2026.kicad_sch]
2025-10-27 Added ground station schematic
    [CSUF_USLI_Ground_2026.kicad_pcb, CSUF_USLI_Ground_2026.kicad_sch, DEV-16771.step]
2025-10-29 Rover Subsystem
    Created "generic" symbol library to hold generic symbols (including the 12v drill created earlier)
    [CSUF-USLI-payload-2026.kicad_sch]
2025-11-01 Revert "Merge pull request #4 from NeverNotJohn/PDR_Schematic"
    This reverts commit b304c00c3a6b217adf7fd74d4069b9ba7e955c17, reversing
    changes made to a2006b1930044f0c3205c7475f893156ef9e6752.
    [CSUF-USLI-payload-2026.kicad_sch, CSUF_USLI_Ground_2026.kicad_pcb, CSUF_USLI_Ground_2026.kicad_sch, DEV-16771.step]
2025-11-02 KiCad does not like merge requests
    [CSUF-USLI-payload-2026.kicad_sch, CSUF_USLI_Ground_2026.kicad_pcb, CSUF_USLI_Ground_2026.kicad_sch]
2025-11-09 BMP280 Library (#5)
    * BMP280 Library
    Added in getters for pressure, temp, relative altitude. Also created a calibrating function.
    * Changed to doubles
    "double calculateBaselinePressure()"
    "dobule getPressure()"
    * Update bmp280.h
    * Update bmp280.cpp
2025-11-09 MPU6050 Init Library (#6)
    * MPU6050 Init Library
    connects via I2C on pins 17+18 at address 0x68 or 0x69 (AD0 pin pulled high).
    * Don't merge this
    can compile because of issues with defines header file
    * Read gyro and accel
    Implementation of "getAcceleration()" and "getAngularAcceleration"
    Vector3D struct is defined in the "MPU6050.h" header file
    * Calculate orientation
    "getAngularAcceleration()" to "getAngularVelocity()" (I am an idiot)
    proof of concept "orientationLoop()"
    Drifts very fast, prints to the serial monitor in degrees not very accurate.
    * complementary filter
    updated "orientationCalculation()".
    - mutates a vec3 in place.
    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
    [defines.h, main.cpp, mpu6050.cpp, mpu6050.h]
2025-11-09 Fixed function output types
    [bmp280.cpp]
2025-11-19 Created I2C header and yeeted to others (#8)
2025-11-25 Bmp280 library (#9)
    * cleaned up lib and preparing for FreeRTOS stuff
    * cleaned code up and increased bmp accuracy
    * cleaned code up and increased bmp accuracy
    * Fixed Mutex Glitches
    ---------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
    [bmp280.cpp, bmp280.h, i2c.cpp, main.cpp]
2025-11-25 Usage of semaphore and a mutex to read sensors without conflict. Implementation of Madgwick filter. (#7)
    * semaphore mutex, madgwick
    can read both the mpu6050 and bmp280 at the "same " time.
    also implements the Madgwick filter for the mpu6050
    * Update main.cpp
    * Refactored main to do my bidding
    * s
    * Created beep task for funzies
    * Added Some comments
    * Added ANNOY_CYAN Flag
    * Fixed Some Spacing
    * Created I2C header and yeeted to others (#8)
    * NEO6M Intergration
    added
    functions to init and get values using the tinygpsplus library
    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
    [bmp280.cpp, defines.h, main.cpp, neo6m.cpp, neo6m.h]
2025-12-07 Main task (#13)
    * changed serial port
    * cleanup n stuff
    * changed serial port
    * cleanup n stuff
    * Made changes to debug
    * Created Main task and added buzzer mutex
    * changed flight counters
    ---------
    Co-authore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
    [defines.h, main.cpp]
2025-12-07 Rylr896 (#14)
    * Create RYLR cpp and header
    * Added comments
    * RYLR896 Won't accept inputs
    * im in pain
    * yata
    * changed LED output pin
    * Added Mutex for coolio stuff
    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
    [RYLR896.cpp, RYLR896.h, main.cpp]
2025-12-23 Logger (#15)
    * mysterious bug has arisen!
    * finished base logger
    [RYLR896.cpp, RYLR896.h, defines.h, i2c.cpp, logger.cpp, logger.h, main.cpp, sdfs.cpp]
2025-12-26 Ground comms (#16)
    * i dont even wanna begin to explain
    * ground station receives yay
    * finished ground station integration
    * finished ground station
2025-12-27 Fixed SD card now Subscale Ready!!!
    [logger.cpp, logger.h, main.cpp, sdfs.cpp, sdfs.h]
2026-01-06 CDR Schematic done
    [CSUF-USLI-payload-2026.kicad_sch]
2026-01-31 Drill Motor Driver (#17)
    * init drill motor
    * implementation
    can drive motor forwards + backwards and stop it.
    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
2026-01-31 soil sensor yay (#18)
2026-02-24 init
    servo control class,
    tweaking lowk
2026-02-27 Revert "init"
    This reverts commit 94947be4726dddcf734dfc7228caaad16aa90498.
    [servocontrol.cpp, servocontrol.h]
2026-02-27 servocontrol files
2026-02-28 legs part 2
2026-02-28 update ground station
2026-03-08 Current VDF
    [CSUF-USLI-payload-2026.kicad_sch]
2026-03-14 MPU 6050 w filter
2026-03-16 mission state servo libs
2026-03-25 Implement PCB Soil Sensor
    Implemented the soil sensor onto the PCB. Constantly prints, packet is not done yet.
2026-03-25 Vdf pcb (#21)
    * Sensor Sled Done Pls Check connections
    * printed stuff
    [CSUF-USLI-payload-2026.kicad_pcb, CSUF-USLI-payload-2026.kicad_sch, DEV-16771.step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]
2026-03-30 Servo speed changes, toggles
2026-04-01 New PCB
    Changed into one board, not all parts are placed, the screw holes are not in the right place as they were based on the measurements of a smaller 3.1inch plate not the 3.5 inch plate. Clearance for legs have already been added to the edge cut. Figure out how to put all the footprints on there (good luck).
    [DEV-16771.step, IRLZ44N.step, main-board-v2.kicad_pcb, main-board-v2.kicad_sch]
2026-04-01 Updated dimensions
    Updated the position of the screw holes and slot. Made the corners rounded to match ig idk.
    [main-board-v2.kicad_pcb]
2026-04-02 placing componenets
    bruh
    [main-board-v2.kicad_pcb, main-board-v2.kicad_sch]
2026-04-05 change drill pin
2026-04-07 fix ground station CSV writing
    [RYLR896.cpp, defines.h, main.cpp, main.py]
2026-04-07 trying to route traces
    bad bad bad
    [main-board-v2.kicad_pcb, main-board-v2.kicad_sch]
2026-04-09 pcb reroute
    traces are doomed 0 errors on DRC!
    [main-board-v2.kicad_pcb]
2026-04-24 fix drill pin, fix chassis stuff, fix soil, test commands
    sheesh
    [RYLR896.cpp, RYLR896.h, defines.h, logger.cpp, main.cpp]
